insper-riscv/RV32I/docs/img/multi-stage-rv32m_pipeline-Pipeline.jpg.jpeg

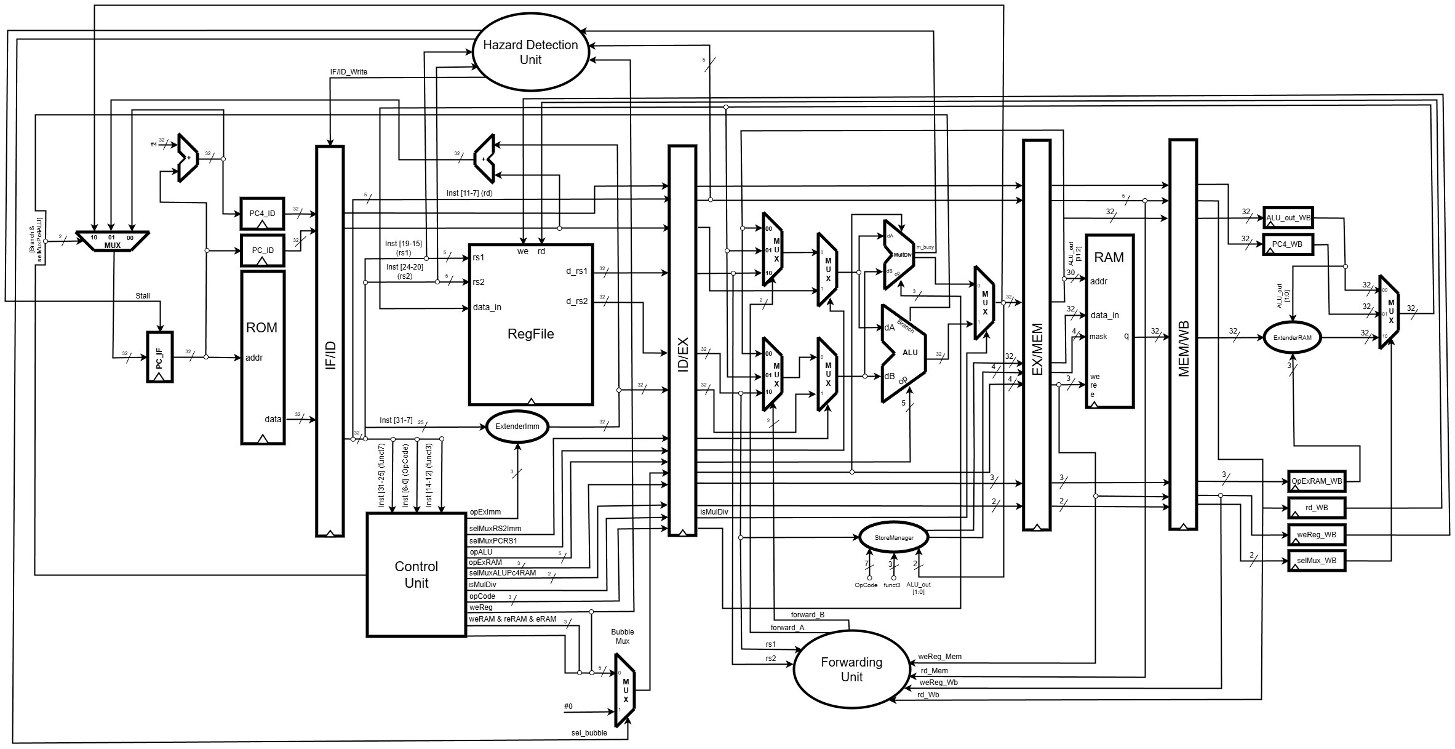
docs/img/multi-stage-rv32m_pipeline-Pipeline.jpg.jpeg
