insper-riscv/RV32I/docs/instructions/greencardRISCV.pdf

Change Level Env. Call Environment Breakpoint Environment Return | ECALL EBREAK ERET
Trap Redirect to SupervisorMRTS Redirect Trap to Hypervisor Hypervisor Trap to Supervisor | MRTH HRTS

Interrupt Wait for InterruptWFI
MMU Supervisor FENCE | SFENCE.VM rs1
Arithmetic | ADD | R | ADD | rd,rs1,rs2
ADD Immediate | I | ADDI | rd,rs1,imm
SUBtract | R | SUB | rd,rs1,rs2
Load Upper Imm | U | LUI | rd,imm
Add Upper Imm to PC | U | AUIPC rd,imm | Category Name | Fmt | RVC | RVI equivalent
Logical XOR XOR Immediate OR OR Immediate AND AND Immediate | R I R I R I | XOR rd,rs1,rs2 XORI rd,rs1,imm OR rd,rs1,rs2 ORI rd,rs1,imm AND rd,rs1,rs2 ANDI rd,rs1,imm | Loads Load Word Load Word SP Load Double Load Double SP Load Quad Load Quad SP | CL CI CL CI CL CI | C.LW rd′,rs1′,imm C.LWSP rd,imm C.LD rd′,rs1′,imm C.LDSP rd,imm C.LQ rd′,rs1′,imm C.LQSP rd,imm | LW rd′,rs1′,imm*4 LW rd,sp,imm*4 LD rd′,rs1′,imm*8 LD rd,sp,imm*8 LQ rd′,rs1′,imm*16 LQ rd,sp,imm*16
Compare Set < Set < Immediate Set < Unsigned Set < Imm Unsigned | R I R I | SLT rd,rs1,rs2 SLTI rd,rs1,imm SLTU rd,rs1,rs2 SLTIU rd,rs1,imm | Stores Store Word Store Word SP Store Double Store Double SP Store Quad Store Quad SP | CS CSS CS CSS CS CSS | C.SW rs1′,rs2′,imm C.SWSP rs2,imm C.SD rs1′,rs2′,imm C.SDSP rs2,imm C.SQ rs1′,rs2′,imm C.SQSP rs2,imm | SW rs1′,rs2′,imm*4 SW rs2,sp,imm*4 SD rs1′,rs2′,imm*8 SD rs2,sp,imm*8 SQ rs1′,rs2′,imm*16 SQ rs2,sp,imm*16
Branches Branch = Branch ≠ Branch < Branch ≥ Branch < Unsigned Branch ≥ Unsigned | SB SB SB SB SB SB | BEQ rs1,rs2,imm BNE rs1,rs2,imm BLT rs1,rs2,imm BGE rs1,rs2,imm BLTU rs1,rs2,imm BGEU rs1,rs2,imm
Jump & Link J&L Jump & Link Register | UJ UJ | JAL rd,imm JALR rd,rs1,imm
Synch Synch thread Synch Instr & Data | I I | FENCE FENCE.I
System System CALL System BREAK | I I | SCALL SBREAK
Counters ReaD CYCLE ReaD CYCLE upper Half ReaD TIME ReaD TIME upper Half ReaD INSTR RETired ReaD INSTR upper Half | I I I I I I | RDCYCLE rd RDCYCLEH rd RDTIME rd RDTIMEH rd RDINSTRET rd RDINSTRETH rd | Shifts Shift Left Imm | CI | C.SLLI rd,imm | SLLI rd,rd,imm
| | | Branches Branch=0 Branch≠0 | CB CB | C.BEQZ rs1′,imm C.BNEZ rs1′,imm | BEQ rs1',x0,imm BNE rs1',x0,imm
| | | Jump Jump Jump Register | CJ CR | C.J imm C.JR rd,rs1 | JAL x0,imm JALR x0,rs1,0

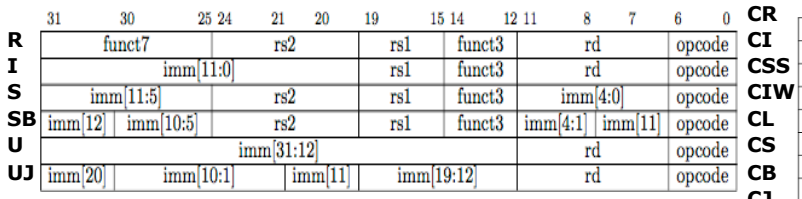
[picture p11: figure]
R CI I CSS S CIW
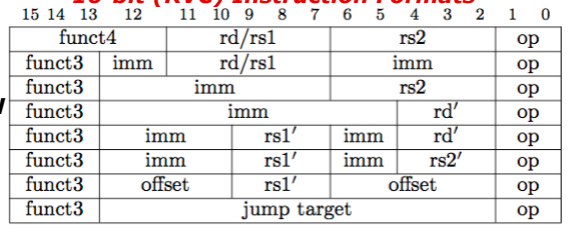
[picture p12: figure]

| | | Jump & Link J&L Jump & Link Register | CJ CR | C.JAL imm C.JALR rs1 | JAL ra,imm JALR ra,rs1,0
| | | System Env. BREAK | CI | C.EBREAK | EBREAK
Arithmetic ADD ADD Word ADD Immediate ADD Word Imm ADD SP Imm * 16 ADD SP Imm * 4 Load Immediate Load Upper Imm MoVe SUB | CR CR CI CI CI CIW CI CI CR CR | C.ADD rd,rs1 C.ADDW rd,rs1 C.ADDI rd,imm C.ADDIW rd,imm C.ADDI16SP x0,imm C.ADDI4SPN rd',imm C.LI rd,imm C.LUI rd,imm C.MV rd,rs1 C.SUB rd,rs1 | ADD rd,rd,rs1 ADDW rd,rd,imm ADDI rd,rd,imm ADDIW rd,rd,imm ADDI sp,sp,imm*16 ADDI rd',sp,imm*4 ADDI rd,x0,imm LUI rd,imm ADD rd,rs1,x0 SUB rd,rd,rs1

CR

CJ
RISC-V Integer Base (RV32I/64I/128I), privileged, and optional compressed extension (RVC). Registers x1-x31 and the pc are 32 bits wide in RV32I, 64 in RV64I, and 128 in RV128I (x0=0). RV64I/128I add 10 instructions for the wider formats. The RVI base of <50 classic integer RISC instructions is required. Every 16-bit RVC instruction matches an existing 32-bit RVI instruction. See risc.org.
32-bit Instruction Formats | 16-bit (RVC) Instruction Formats

ADD{W|D} rd,rs1,rs2 ADDI{W|D} rd,rs1,imm SUB{W|D} rd,rs1,rs2

## Optional Compressed (16-bit) Instruction Extension: RVC

Free & Open | Reference Card | ①
Base Integer Instructions: RV32I, RV64I, and RV128I | RV Privileged Instructions
Category Name | Fmt | RV32I Base | +RV{64,128} | Category Name | RV mnemonic
Loads Load Byte Load Halfword Load Word Load Byte Unsigned Load Half Unsigned | I I I I I | LB rd,rs1,imm LH rd,rs1,imm LW rd,rs1,imm LBU rd,rs1,imm LHU rd,rs1,imm | L{D|Q} rd,rs1,imm L{W|D}U rd,rs1,imm | CSR Access Atomic R/W Atomic Read & Set Bit Atomic Read & Clear Bit Atomic R/W Imm Atomic Read & Set Bit Imm Atomic Read & Clear Bit Imm | CSRRW rd,csr,rs1 CSRRS rd,csr,rs1 CSRRC rd,csr,rs1 CSRRWI rd,csr,imm CSRRSI rd,csr,imm CSRRCI rd,csr,imm
Stores Store Byte Store Halfword Store Word | S S S | SB rs1,rs2,imm SH rs1,rs2,imm SW rs1,rs2,imm | S{D|Q} rs1,rs2,imm
Shifts Shift Left Shift Left Immediate Shift Right Shift Right Immediate Shift Right Arithmetic Shift Right Arith Imm | R I R I R I | SLL rd,rs1,rs2 SLLI rd,rs1,shamt SRL rd,rs1,rs2 SRLI rd,rs1,shamt SRA rd,rs1,rs2 SRAI rd,rs1,shamt | SLL{W|D} rd,rs1,rs2 SLLI{W|D} rd,rs1,shamt SRL{W|D} rd,rs1,rs2 SRLI{W|D} rd,rs1,shamt SRA{W|D} rd,rs1,rs2 SRAI{W|D} rd,rs1,shamt

Category Name | Fmt | RV32M (Multiply-Divide) | +RV{64,128}
Multiply MULtiply MULtiply upper Half MULtiply Half Sign/Uns MULtiply upper Half Uns Divide DIVide DIVide Unsigned Remainder REMainder REMainder Unsigned | R R R R R R R R | MUL rd,rs1,rs2 MULH rd,rs1,rs2 MULHSU rd,rs1,rs2 MULHU rd,rs1,rs2 DIV rd,rs1,rs2 DIVU rd,rs1,rs2 REM rd,rs1,rs2 REMU rd,rs1,rs2 | MUL{W|D} rd,rs1,rs2 DIV{W|D} rd,rs1,rs2 REM{W|D} rd,rs1,rs2 REMU{W|D} rd,rs1,rs2
Category Name | Fmt | RV32A (Atomic) | +RV{64,128}
Load Load Reserved | R | LR.W rd,rs1 | LR.{D|Q} rd,rs1
Store Store Conditional | R | SC.W rd,rs1,rs2 | SC.{D|Q} rd,rs1,rs2
Swap SWAP | R | AMOSWAP.W rd,rs1,rs2 | AMOSWAP.{D|Q} rd,rs1,rs2
Add ADD | R | AMOADD.W rd,rs1,rs2 | AMOADD.{D|Q} rd,rs1,rs2
Logical XOR AND OR | R R R | AMOXOR.W rd,rs1,rs2 AMOAND.W rd,rs1,rs2 AMOOR.W rd,rs1,rs2 | AMOXOR.{D|Q} rd,rs1,rs2 AMOAND.{D|Q} rd,rs1,rs2 AMOOR.{D|Q} rd,rs1,rs2
Min/Max MINimum MAXimum MINimum Unsigned MAXimum Unsigned | R R R R | AMOMIN.W rd,rs1,rs2 AMOMAX.W rd,rs1,rs2 AMOMINU.W rd,rs1,rs2 AMOMAXU.W rd,rs1,rs2 | AMOMIN.{D|Q} rd,rs1,rs2 AMOMAX.{D|Q} rd,rs1,rs2 AMOMINU.{D|Q} rd,rs1,rs2 AMOMAXU.{D|Q} rd,rs1,rs2
Category Name | Fmt | RV32{F|D|Q} (HP/SP,DP,QP Fl Pt) | +RV{64,128}
Move Move from Integer Move to Integer | R R | FMV.{H|S}.X rd,rs1 FMV.X.{H|S} rd,rs1 | FMV.{D|Q}.X rd,rs1 FMV.X.{D|Q} rd,rs1
Convert Convert from Int Convert from Int Unsigned Convert to Int Convert to Int Unsigned | R R R R | FCVT.{H|S|D|Q}.W rd,rs1 FCVT.{H|S|D|Q}.WU rd,rs1 FCVT.W.{H|S|D|Q} rd,rs1 FCVT.WU.{H|S|D|Q} rd,rs1 | FCVT.{H|S|D|Q}.{L|T} rd,rs1 FCVT.{H|S|D|Q}.{L|T}U rd,rs1 FCVT.{L|T}.{H|S|D|Q} rd,rs1 FCVT.{L|T}U.{H|S|D|Q} rd,rs1
Load Load | I | FL{W,D,Q} rd,rs1,imm | RISC-V Calling Convention
Store Store | S | FS{W,D,Q} rs1,rs2,imm | Register | ABI Name | Saver | Description
Arithmetic ADD SUBtract MULtiply DIVide SQuare RooT | R R R R R | FADD.{S|D|Q} rd,rs1,rs2 FSUB.{S|D|Q} rd,rs1,rs2 FMUL.{S|D|Q} rd,rs1,rs2 FDIV.{S|D|Q} rd,rs1,rs2 FSQRT.{S|D|Q} rd,rs1 | x0 x1 x2 x3 x4 x5-7 x8 x9 x10-11 x12-17 x18-27 x28-31 | zero ra sp gp tp t0-2 s0/fp s1 a0-1 a2-7 s2-11 t3-t6 | ---Caller Callee ------Caller Callee Callee Caller Caller Callee Caller | Hard-wired zero Return address Stack pointer Global pointer Thread pointer Temporaries Saved register/frame pointer Saved register Function arguments/return values Function arguments Saved registers Temporaries
Mul-Add Multiply-ADD Multiply-SUBtract Negative Multiply-SUBtract Negative Multiply-ADD | R R R R | FMADD.{S|D|Q} rd,rs1,rs2,rs3 FMSUB.{S|D|Q} rd,rs1,rs2,rs3 FNMSUB.{S|D|Q} rd,rs1,rs2,rs3 FNMADD.{S|D|Q} rd,rs1,rs2,rs3
Sign Inject SiGN source Negative SiGN source Xor SiGN source | R R R | FSGNJ.{S|D|Q} rd,rs1,rs2 FSGNJN.{S|D|Q} rd,rs1,rs2 FSGNJX.{S|D|Q} rd,rs1,rs2
Min/Max MINimum MAXimum | R R | FMIN.{S|D|Q} rd,rs1,rs2 FMAX.{S|D|Q} rd,rs1,rs2 | f0-7 f8-9 f10-11 f12-17 f18-27 f28-31 | ft0-7 fs0-1 fa0-1 fa2-7 fs2-11 ft8-11 | Caller Callee Caller Caller Callee Caller | FP temporaries FP saved registers FP arguments/return values FP arguments FP saved registers FP temporaries
Compare Compare Float = Compare Float < Compare Float ≤ Categorization Classify Type | R R R R | FEQ.{S|D|Q} rd,rs1,rs2 FLT.{S|D|Q} rd,rs1,rs2 FLE.{S|D|Q} rd,rs1,rs2 FCLASS.{S|D|Q} rd,rs1
Configuration Read Status Read Rounding Mode Read Flags Swap Status Reg Swap Rounding Mode Swap Flags Swap Rounding Mode Imm Swap Flags Imm | R R R R R R I I | FRCSR rd FRRM rd FRFLAGS rd FSCSR rd,rs1 FSRM rd,rs1 FSFLAGS rd,rs1 FSRMI rd,imm FSFLAGSI rd,imm

RISC-V calling convention and five optional extensions: 10 multiply-divide instructions (RV32M); 11 optional atomic instructions (RV32A); and 25 floating-point instructions each for single-, double-, and quadruple-precision (RV32F, RV32D, RV32Q). The latter add registers f0-f31, whose width matches the widest precision, and a floating-point control and status register fcsr. Each larger address adds some instructions: 4 for RVM, 11 for RVA, and 6 each for RVF/D/Q. Using regex notation, {} means set, so L{D|Q} is both LD and LQ. See risc.org. (8/21/15 revision)

## Three Optional Floating-Point Instruction Extensions: RVF, RVD, & RVQ

## Optional Atomic Instruction Extension: RVA

Free & Open | Reference Card (riscv.org) ② Optional Multiply-Divide Instruction Extension: RVM
