insper-riscv/RV32I/tests/python/unittests/entities/data/riscv_opcodes.csv

INST | IMPL | OpCode[6:0] | funct3[2:0] | funct7[6:0] | SelMuxPc4ALU | opExImm[2:0] | selMuxALUPc4RAM[1:0] | weReg | opExRAM[2:0] | selMuxRS2Imm | selMUXPcRS1 | opALU[4:0] | reRAM | eRAM | weRAM
LUI | x[rd] = sext(imm << 12) | 0110111 | - | - | 0 | U | 00 | 1 | XXX | 1 | X | PASS_B | 0 | 0 | 0
AUIPC | x[rd] = pc + sext(imm << 12) | 0010111 | - | - | 0 | U | 00 | 1 | XXX | 1 | 0 | ADD | 0 | 0 | 0
ADDI | x[rd] = x[rs1] + sext(imm) | 0010011 | 000 | - | 0 | I | 00 | 1 | XXX | 1 | 1 | ADD | 0 | 0 | 0
XORI | x[rd] = x[rs1] ^ sext(imm) | 0010011 | 100 | - | 0 | I | 00 | 1 | XXX | 1 | 1 | XOR | 0 | 0 | 0
ORI | x[rd] = x[rs1] | sext(imm) | 0010011 | 110 | - | 0 | I | 00 | 1 | XXX | 1 | 1 | OR | 0 | 0 | 0
ANDI | x[rd] = x[rs1] & sext(imm) | 0010011 | 111 | - | 0 | I | 00 | 1 | XXX | 1 | 1 | AND | 0 | 0 | 0
SLLI | x[rd] = x[rs1] << shamt | 0010011 | 001 | 0000000 | 0 | I_shamt | 00 | 1 | XXX | 1 | 1 | SLL | 0 | 0 | 0
SRLI | x[rd] = x[rs1] >>u shamt | 0010011 | 101 | 0000000 | 0 | I_shamt | 00 | 1 | XXX | 1 | 1 | SRL | 0 | 0 | 0
SRAI | x[rd] = x[rs1] >>s shamt | 0010011 | 101 | 0100000 | 0 | I_shamt | 00 | 1 | XXX | 1 | 1 | SRA | 0 | 0 | 0
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
