insper-riscv/RV32I/L2IP/hw/RTL View Completo 11 03 2026.pdf

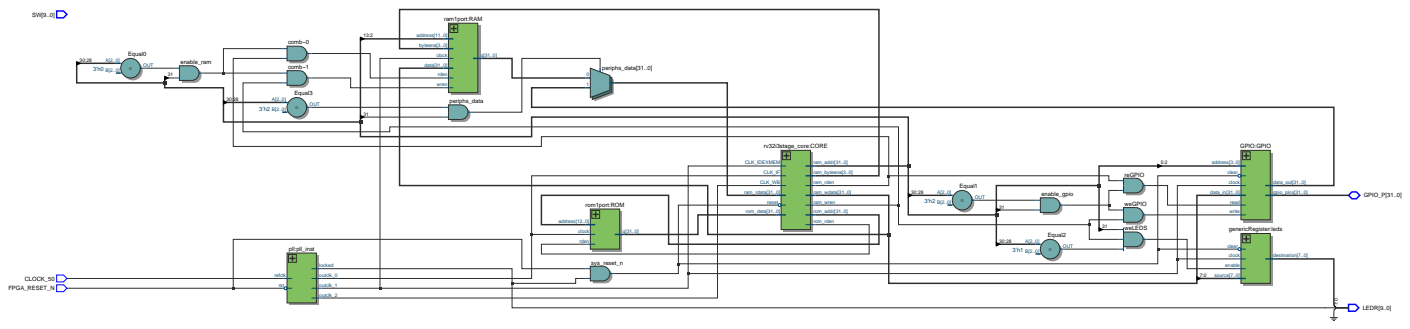
[picture p15: page 1]
CLOCK_50 FPGA_RESET_N; Equal0; OUT; enable_ram; comb~0 comb~1 =; Equal3; pll:pll_inst; refclk; rst; locked; outclk_0; outclk_1; outclk_2; ram1port:RAM; clock; rden wren; address[11..0] byteena[3..0]; data[31..0]; periphs_data; periphs_data[31..0] 01; rom1port:ROM; rden; address[12..0]; sys_reset_n; rv32i3stage_core:CORE; CLK_IDEXMEM; CLK_IF CLK_WB; reset; rom_data[31..0]; ram_rdata[31..0]; ram_rden; ram_wren; rom_rden; rom_addr[31..0]; ram_addr[31..0]; ram_wdata[31..0]; ram_byteena[3..0]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
