insper-riscv/RV32I/src/rv32im_pipeline_core.vhd

-- =============================================================================
-- rv32im_pipeline_core.vhd
-- Top-level do pipeline RV32IM 5 estagios -- PIPELINE COMPLETO
-- M1: IF + ID + Control Unit + Bubble Mux + HDU + reg_IF_ID + reg_ID_EX
-- M2: EX + reg_EX_MEM + Forwarding Unit + muxes de operandos + logica de branch
-- M3: MEM + WB + reg_MEM_WB + ExtenderRAM + mux final de WB
--
-- EVOLUCAO M3 em relacao a M2:
--   1. Estagio MEM: conectado diretamente via sinais exmem_* (ja estava
--      parcialmente feito em M2). A RAM tem leitura sincrona de 1 ciclo.
--   2. Estagio WB completamente instanciado:
--      - reg_MEM_WB captura metadata do MEM (NAO captura ram_rdata, pois
--        a RAM e registrada e o dado chega no ciclo WB naturalmente).
--      - ExtenderRAM posicionado em WB: recebe ram_rdata + opExRAM_WB +
--        alu_out_WB[1:0] (EA = byte offset) e produz o dado de load extendido.
--      - Mux final de WB: seleciona entre ALU, PC+4 e saida do ExtenderRAM
--        de acordo com selMuxALUPc4RAM_WB.
--   3. Loop do RegFile fechado:
--      - wb_we   <- memwb_weReg
--      - wb_rd   <- memwb_rd_idx
--      - wb_data <- saida do mux final de WB
--   4. Forwarding Unit atualizado: agora conecta memwb_rd_idx e memwb_weReg
--      diretamente (em M2 eram stubs apontando para wb_we/wb_rd constantes).
--
-- CONVENCAO DE ENCODING DO wbsel_t (usado em selMuxALUPc4RAM):
--   "00" = ALU (R-type, I-type ALU, AUIPC, LUI)
--   "01" = PC+4 (JAL, JALR)
--   "10" = RAM extendida (LW/LH/LB/LHU/LBU)
--
--   ATENCAO: Verificar se a Control Unit usa este mesmo encoding ao atribuir
--   selMuxALUPc4RAM. Se usar outra convencao, basta reordenar os casos no
--   mux final de WB (procurar por "Mux final de WB" abaixo).
-- =============================================================================

library ieee;
use ieee.std_logic_1164.all;
use ieee.numeric_std.all;
use work.rv32i_ctrl_consts.all;
use work.rv32im_pipeline_types.all;

entity rv32im_pipeline_core is
  port (
    clk   : in  std_logic;
    reset : in  std_logic;

    -- Interface de busca de instrucao (estagio IF) -- barramento UNICO
    -- compartilhado por BOOT_ROM e FLASH (ambas sempre respondem ao
    -- mesmo endereco if_pc todo ciclo; is_boot_rom_if/is_boot_rom_d
    -- abaixo decidem qual dado confiar). 3 memorias fisicas agora:
    -- BOOT_ROM (fixa, gravada uma unica vez, nunca reescrita via JTAG
    -- por teste) + FLASH (o "firmware", reescrita por teste) + RAM
    -- (dados de verdade, unico consumidor do estagio MEM). Ver
    -- link.ld/config.yaml memory.boot_rom_words/rom_words/ram_words.
    if_addr       : out std_logic_vector(31 downto 0);
    if_rden       : out std_logic;
    boot_rom_data : in  std_logic_vector(31 downto 0);
    flash_data    : in  std_logic_vector(31 downto 0);

    -- Interface de leitura de dado pelo estagio MEM, so' para FLASH
    -- (BOOT_ROM nunca tem .data proprio -- ver boot_rom.S -- entao
    -- nunca precisa ser lido como dado). Necessaria especificamente
    -- para o copy-loop de _boot_continue (boot_rom.S) conseguir ler
    -- .data da FLASH (a fonte, LMA) e escrever na RAM (o destino,
    -- VMA) -- confirmado em hardware real que sem isso o `lw` do
    -- copy-loop simplesmente nao alcancava FLASH (so' RAM), entao
    -- .data nunca era copiado (bss/computo funcionavam normalmente,
    -- so' .data inicializado ficava zerado). Fiel ao que uma SoC de
    -- verdade faz (a CPU le a Flash como dado pra copiar pra RAM no
    -- boot, via o mesmo controlador memory-mapped que atende busca de
    -- instrucao) -- a segunda instancia fisica do lado de hardware
    -- real (ver core_fpga_test.vhd FLASH_MEM) e' um artefato do
    -- Quartus Lite (DUAL_PORT + ENABLE_RUNTIME_MOD nao compilam
    -- juntos), nao algo que uma SoC real precisaria.
    flash_addr2 : out std_logic_vector(31 downto 0);
    flash_rden2 : out std_logic;
    flash_data2 : in  std_logic_vector(31 downto 0);

    -- Interface com a RAM
    ram_addr    : out std_logic_vector(31 downto 0);
    ram_wdata   : out std_logic_vector(31 downto 0);
    ram_rdata   : in  std_logic_vector(31 downto 0);
    ram_en      : out std_logic;
    ram_wren    : out std_logic;
    ram_rden    : out std_logic;
    ram_byteena : out std_logic_vector(3 downto 0)
  );
end entity rv32im_pipeline_core;

architecture rtl of rv32im_pipeline_core is

  -- =========================================================================
  -- Sinais de controle de hazard (gerados pela HDU)
  -- =========================================================================
  signal if_pc_write_en : std_logic;
  signal ifid_write_en  : std_logic;
  signal id_bubble_sel  : std_logic;

  -- =========================================================================
  -- Sinais de controle de branch (gerados no estagio EX)
  -- =========================================================================
  signal ex_branch_taken  : std_logic;
  signal ex_jalr_taken    : std_logic;
  signal ex_branch_target : word_t;
  signal ex_jalr_target   : word_t;
  signal pc_src           : std_logic_vector(1 downto 0);

  signal flush_if_id : std_logic;
  signal flush_id_ex : std_logic;

  -- =========================================================================
  -- Stall do muldiv (combinacional = sempre '0' nesta implementacao)
  -- =========================================================================
  signal muldiv_busy   : std_logic;
  signal muldiv_done   : std_logic;
  signal muldiv_stall  : std_logic;  -- busy OR done (cobre ciclo em que saida_capt atualiza)
  signal muldiv_stall_n : std_logic;  -- NOT muldiv_stall (para port maps VHDL-93)

  -- Aliases para visibilidade nos testbenches cocotb
  signal alu_out_idexmem  : word_t;
  signal pc_if_out        : word_t;
  signal extenderRAM_out  : word_t;
  signal ram_out          : std_logic_vector(31 downto 0);

  -- =========================================================================
  -- Estagio IF: pc_fetch
  -- =========================================================================
  signal if_pc  : word_t;
  signal if_pc4 : word_t;

  -- BOOT_ROM x FLASH: decodificacao de endereco de busca, puramente
  -- combinacional (ver comentario junto do mux, mais abaixo, para o
  -- porque de NAO ter um registrador aqui -- um registrador extra
  -- causou um bug real de alinhamento de clock, so' visivel em
  -- hardware real, nao no GHDL).
  --
  -- 2K (512 words) -- folga confortavel para o bootloader fixo
  -- (boot_rom.S: trampolim + copy-loop + bss-zero + rv32_wait_restart),
  -- sem TLS/outras miudezas que o crt0.S antigo carregava mas nada
  -- usa. Precisa bater com boot_rom.ld (BOOT_ROM_SIZE) e config.yaml
  -- memory.boot_rom_words (=512).
  constant BOOT_ROM_SIZE_BYTES : unsigned(31 downto 0) := to_unsigned(16#00000800#, 32);
  signal is_boot_rom_if : std_logic;
  signal if_instr_mux   : std_logic_vector(31 downto 0);

  -- FLASH x RAM: decodificacao de endereco de dado (estagio MEM/WB) --
  -- ver comentario junto do mux, na secao do estagio MEM. RAM_BASE_BYTES
  -- precisa bater com config.yaml memory.ram_base.
  constant RAM_BASE_BYTES : unsigned(31 downto 0) := to_unsigned(16#00008000#, 32);
  signal is_flash_data    : std_logic;  -- decodificado no estagio MEM (exmem_alu_out)
  signal is_flash_data_wb : std_logic;  -- mesmo decode, 1 ciclo depois, para o mux de WB
  signal mem_read_data    : std_logic_vector(31 downto 0);  -- FLASH(porta 2) ou RAM, o que o WB consome

  -- =========================================================================
  -- Registrador IF/ID
  -- =========================================================================
  signal ifid_valid : std_logic;
  signal ifid_pc    : word_t;
  signal ifid_pc4   : word_t;
  signal ifid_instr : word_t;

  signal ifid_rs1 : reg_t;
  signal ifid_rs2 : reg_t;

  -- =========================================================================
  -- Estagio ID
  -- =========================================================================
  signal id_rs1_idx : reg_t;
  signal id_rs2_idx : reg_t;
  signal id_rd_idx  : reg_t;
  signal id_rs1_val : word_t;
  signal id_rs2_val : word_t;
  signal id_imm     : word_t;

  -- =========================================================================
  -- Control Unit
  -- =========================================================================
  signal cu_selMuxPc4ALU    : std_logic;
  signal cu_opExImm         : opeximm_t;
  signal cu_selMuxALUPc4RAM : wbsel_t;
  signal cu_weReg           : std_logic;
  signal cu_opExRAM         : opexram_t;
  signal cu_selMuxRS2Imm    : std_logic;
  signal cu_selPCRS1        : std_logic;
  signal cu_opALU           : opalu_t;
  signal cu_isMulDiv        : std_logic;
  signal cu_weRAM           : std_logic;
  signal cu_reRAM           : std_logic;
  signal cu_eRAM            : std_logic;
  signal cu_opCode          : std_logic_vector(6 downto 0);
  signal cu_funct3          : std_logic_vector(2 downto 0);

  signal isMulDiv_d   : std_logic := '0';
  signal startMul_raw : std_logic;

  -- =========================================================================
  -- Bubble Mux
  -- =========================================================================
  signal bm_weReg           : std_logic;
  signal bm_startMul        : std_logic;
  signal bm_weRAM           : std_logic;
  signal bm_reRAM           : std_logic;
  signal bm_eRAM            : std_logic;
  signal idex_in_valid      : std_logic;

  -- =========================================================================
  -- Saidas do reg_ID_EX (entradas do estagio EX)
  -- =========================================================================
  signal ex_valid           : std_logic;
  signal ex_pc              : word_t;
  signal ex_pc4             : word_t;
  signal ex_rs1_idx         : reg_t;
  signal ex_rs2_idx         : reg_t;
  signal ex_rd_idx          : reg_t;
  signal ex_rs1_val         : word_t;
  signal ex_rs2_val         : word_t;
  signal ex_imm             : word_t;
  signal ex_selMuxPc4ALU    : std_logic;
  signal ex_selMuxALUPc4RAM : wbsel_t;
  signal ex_weReg           : std_logic;
  signal ex_opExRAM         : opexram_t;
  signal ex_selMuxRS2Imm    : std_logic;
  signal ex_selPCRS1        : std_logic;
  signal ex_opALU           : opalu_t;
  signal ex_isMulDiv        : std_logic;
  signal ex_startMul        : std_logic;
  signal ex_weRAM           : std_logic;
  signal ex_reRAM           : std_logic;
  signal ex_eRAM            : std_logic;
  signal ex_opCode          : std_logic_vector(6 downto 0);
  signal ex_funct3          : std_logic_vector(2 downto 0);

  -- =========================================================================
  -- Estagio EX: forwarding e operandos
  -- =========================================================================
  signal ex_forward_a   : std_logic_vector(1 downto 0);
  signal ex_forward_b   : std_logic_vector(1 downto 0);
  signal ex_fwd_rs1_val : word_t;
  signal ex_fwd_rs2_val : word_t;
  signal ex_alu_op_a    : word_t;
  signal ex_alu_op_b    : word_t;
  signal exmem_weReg_fwd : std_logic;
  signal memwb_weReg_fwd : std_logic;

  -- =========================================================================
  -- Estagio EX: resultados
  -- =========================================================================
  signal ex_alu_result      : word_t;
  signal ex_alu_branch_flag : std_logic;
  signal ex_muldiv_result   : word_t;
  signal ex_alu_mux_result  : word_t;
  signal ex_final_result    : word_t;

  -- =========================================================================
  -- Estagio EX: StoreManager
  -- =========================================================================
  signal ex_store_data    : word_t;
  signal ex_store_byteena : std_logic_vector(3 downto 0);

  -- =========================================================================
  -- Saidas do reg_EX_MEM (entradas do estagio MEM)
  -- =========================================================================
  signal exmem_valid           : std_logic;
  signal exmem_pc4             : word_t;
  signal exmem_alu_out         : word_t;
  signal exmem_store_data      : word_t;
  signal exmem_byteena         : std_logic_vector(3 downto 0);
  signal exmem_rd_idx          : reg_t;
  signal exmem_weReg           : std_logic;
  signal exmem_weRAM           : std_logic;
  signal exmem_reRAM           : std_logic;
  signal exmem_eRAM            : std_logic;
  signal exmem_opExRAM         : opexram_t;
  signal exmem_selMuxALUPc4RAM : wbsel_t;

  -- =========================================================================
  -- Saidas do reg_MEM_WB (entradas do estagio WB)
  -- =========================================================================
  signal memwb_valid           : std_logic;
  signal memwb_pc4             : word_t;
  signal memwb_alu_out         : word_t;
  signal memwb_rd_idx          : reg_t;
  signal memwb_weReg           : std_logic;
  signal memwb_opExRAM         : opexram_t;
  signal memwb_selMuxALUPc4RAM : wbsel_t;

  -- =========================================================================
  -- Estagio WB: saida do ExtenderRAM (dado de load extendido)
  -- =========================================================================
  signal wb_ram_extended : word_t;

  -- =========================================================================
  -- Write-back: sinais que fecham o loop no RegFile
  -- =========================================================================
  signal wb_we   : std_logic;
  signal wb_rd   : reg_t;
  signal wb_data : word_t;

begin

  -- Aliases de observabilidade para testbenches cocotb
  alu_out_idexmem <= exmem_alu_out;
  pc_if_out       <= if_pc;
  extenderRAM_out <= wb_ram_extended;
  ram_out         <= ram_rdata;

  -- =========================================================================
  -- Logica combinacional de controle de PC e flush
  -- =========================================================================
  pc_src <= "10" when ex_jalr_taken   = '1' else
            "01" when ex_branch_taken = '1' else
            "00";

  flush_if_id <= ex_branch_taken or ex_jalr_taken;
  flush_id_ex <= ex_branch_taken or ex_jalr_taken;

  -- =========================================================================
  -- Edge detect de isMulDiv para gerar startMul (pulso de 1 ciclo)
  -- =========================================================================
  process(clk)
  begin
    if rising_edge(clk) then
      if reset = '1' then
        isMulDiv_d <= '0';
      elsif ifid_write_en = '1' then
        isMulDiv_d <= cu_isMulDiv;
      end if;
    end if;
  end process;

  startMul_raw <= cu_isMulDiv and (not isMulDiv_d);

  -- BUG TIMING (resolvido): saida_capt no multdiv eh atualizado na borda quando done_int=1.
  -- No ciclo em que done_int=1, busy ja caiu para 0 (Booth foi para S_DONE no ciclo anterior).
  -- Sem este OR done, reg_EX_MEM capturaria saida_capt VELHO nesse ciclo.
  -- Com "OR done", o stall continua por 1 ciclo extra ate saida_capt propagar.
  muldiv_stall   <= muldiv_busy or muldiv_done;
  muldiv_stall_n <= not (muldiv_busy or muldiv_done);

  idex_in_valid <= ifid_valid and (not id_bubble_sel);

  -- =========================================================================
  -- Campos extraidos da instrucao em IF/ID
  -- =========================================================================
  ifid_rs1   <= ifid_instr(19 downto 15);
  ifid_rs2   <= ifid_instr(24 downto 20);
  id_rs1_idx <= ifid_instr(19 downto 15);
  id_rs2_idx <= ifid_instr(24 downto 20);
  id_rd_idx  <= ifid_instr(11 downto 7);

  -- =========================================================================
  -- IF stage: pc_fetch
  -- =========================================================================
  u_pc_fetch : entity work.pc_fetch
    port map (
      clk            => clk,
      reset          => reset,
      if_pc_write_en => if_pc_write_en,
      pc_src         => pc_src,
      branch_target  => ex_branch_target,
      jalr_target    => ex_jalr_target,
      pc_out         => if_pc,
      pc4_out        => if_pc4,
      rom_addr       => if_addr,
      rom_rden       => if_rden
    );

  -- BOOT_ROM x FLASH: decode + mux (ver comentario junto do sinal, acima).
  --
  -- BUG REAL, CONFIRMADO EM HARDWARE (nao aparecia no GHDL): a versao
  -- anterior deste trecho REGISTRAVA is_boot_rom_if (is_boot_rom_d,
  -- amostrado em `clk` = pll_clk_idexmem) antes de usar no mux. Isso
  -- introduz UM CICLO A MAIS de atraso do que o necessario, porque
  -- reg_IF_ID tambem captura in_pc <= if_pc DIRETO (sem registrador
  -- extra) -- para o endereco (in_pc) e a instrucao (in_instr) ficarem
  -- alinhados no MESMO ciclo de captura, o select do mux tem que usar
  -- o MESMO if_pc "atual" (pre-borda), nao uma copia atrasada.
  --
  -- No hardware real, pll_clk_if e pll_clk_idexmem sao saidas
  -- ESTAGADAS da MESMA PLL (ver src/PLL/pll_0002.v: outclk_0 fase 0,
  -- outclk_1 fase 6667ps -- 1/3 de um periodo de 20ns), nao um clock
  -- unico como o clk_gen_3way do GHDL modelava (sem essa defasagem
  -- real) -- e' exatamente essa defasagem real que expos o
  -- off-by-one: com o registrador extra, o mux acabava selecionando
  -- com o endereco de DOIS ciclos atras em vez de um, entao a
  -- instrucao que reg_IF_ID capturava nunca correspondia ao PC real
  -- (o core nunca saia do boot corretamente -- mailbox nunca era
  -- escrita, confirmado via `riscv-tools run` na placa).
  --
  -- Combinacional resolve: is_boot_rom_if (decodificado do if_pc
  -- "atual", pre-borda) e' exatamente o mesmo sinal que reg_IF_ID usa
  -- para in_pc nesse mesmo instante -- sem registrador extra, sem
  -- reset explicito precisando tratar o vetor de reset (if_pc=0 no
  -- reset ja decodifica '1' sozinho, ja que 0 < BOOT_ROM_SIZE_BYTES).
  is_boot_rom_if <= '1' when unsigned(if_pc) < BOOT_ROM_SIZE_BYTES else '0';

  if_instr_mux <= boot_rom_data when is_boot_rom_if = '1' else flash_data;

  -- =========================================================================
  -- Registrador IF/ID
  -- =========================================================================
  u_reg_if_id : entity work.reg_IF_ID
    port map (
      clk           => clk,
      reset         => reset,
      ifid_write_en => ifid_write_en,
      flush         => flush_if_id,
      in_pc         => if_pc,
      in_pc4        => if_pc4,
      in_instr      => if_instr_mux,
      ifid_valid    => ifid_valid,
      ifid_pc       => ifid_pc,
      ifid_pc4      => ifid_pc4,
      ifid_instr    => ifid_instr
    );

  -- =========================================================================
  -- ID stage: Control Unit
  -- =========================================================================
  u_control_unit : entity work.control_unit
    port map (
      instruction     => ifid_instr,
      selMuxPc4ALU    => cu_selMuxPc4ALU,
      opExImm         => cu_opExImm,
      selMuxALUPc4RAM => cu_selMuxALUPc4RAM,
      weReg           => cu_weReg,
      opExRAM         => cu_opExRAM,
      selMuxRS2Imm    => cu_selMuxRS2Imm,
      selPCRS1        => cu_selPCRS1,
      opALU           => cu_opALU,
      isMulDiv        => cu_isMulDiv,
      weRAM           => cu_weRAM,
      reRAM           => cu_reRAM,
      eRAM            => cu_eRAM,
      opCode          => cu_opCode,
      funct3_out      => cu_funct3
    );

  -- =========================================================================
  -- ID stage: ExtenderImm
  -- =========================================================================
  u_extender_imm : entity work.ExtenderImm
    port map (
      Inst31downto7 => ifid_instr(31 downto 7),
      opExImm       => std_logic_vector(cu_opExImm),
      signalOut     => id_imm
    );

  -- =========================================================================
  -- ID stage: RegFile
  -- Agora com loop fechado: wb_we/wb_rd/wb_data vem do estagio WB.
  -- =========================================================================
  u_regfile : entity work.RegFile
    port map (
      clk     => clk,
      clear   => reset,
      we      => wb_we,
      rs1     => id_rs1_idx,
      rs2     => id_rs2_idx,
      rd      => wb_rd,
      data_in => wb_data,
      d_rs1   => id_rs1_val,
      d_rs2   => id_rs2_val
    );

  -- =========================================================================
  -- Hazard Detection Unit
  -- =========================================================================
  u_hdu : entity work.hazard_detection_unit
    port map (
      ifid_valid     => ifid_valid,
      ifid_rs1       => ifid_rs1,
      ifid_rs2       => ifid_rs2,
      ifid_opcode    => ifid_instr(6 downto 0),
      idex_rd        => ex_rd_idx,
      idex_reRAM     => ex_reRAM,
      muldiv_busy    => muldiv_stall,
      if_pc_write_en => if_pc_write_en,
      ifid_write_en  => ifid_write_en,
      id_bubble_sel  => id_bubble_sel
    );

  -- =========================================================================
  -- Bubble Mux
  -- =========================================================================
  u_bubble_mux : entity work.bubble_mux
    port map (
      sel_bubble        => id_bubble_sel,
      weReg_i           => cu_weReg,
      weRAM_i           => cu_weRAM,
      reRAM_i           => cu_reRAM,
      eRAM_i            => cu_eRAM,
      startMul_i        => startMul_raw,
      weReg_o           => bm_weReg,
      weRAM_o           => bm_weRAM,
      reRAM_o           => bm_reRAM,
      eRAM_o            => bm_eRAM,
      startMul_o        => bm_startMul
    );

  -- =========================================================================
  -- Registrador ID/EX
  -- =========================================================================
  u_reg_id_ex : entity work.reg_ID_EX
    port map (
      clk    => clk,
      reset  => reset,
      en     => muldiv_stall_n,
      flush  => flush_id_ex,

      in_valid   => idex_in_valid,
      in_pc      => ifid_pc,
      in_pc4     => ifid_pc4,
      in_rs1_idx => id_rs1_idx,
      in_rs2_idx => id_rs2_idx,
      in_rd_idx  => id_rd_idx,
      in_rs1_val => id_rs1_val,
      in_rs2_val => id_rs2_val,
      in_imm     => id_imm,

      in_selMuxPc4ALU    => cu_selMuxPc4ALU,
      in_selMuxALUPc4RAM => cu_selMuxALUPc4RAM,
      in_weReg           => bm_weReg,
      in_opExRAM         => cu_opExRAM,
      in_selMuxRS2Imm    => cu_selMuxRS2Imm,
      in_selPCRS1        => cu_selPCRS1,
      in_opALU           => cu_opALU,
      in_isMulDiv        => cu_isMulDiv,
      in_startMul        => bm_startMul,
      in_weRAM           => bm_weRAM,
      in_reRAM           => bm_reRAM,
      in_eRAM            => bm_eRAM,
      in_opCode          => cu_opCode,
      in_funct3          => cu_funct3,

      idex_valid           => ex_valid,
      idex_pc              => ex_pc,
      idex_pc4             => ex_pc4,
      idex_rs1_idx         => ex_rs1_idx,
      idex_rs2_idx         => ex_rs2_idx,
      idex_rd_idx          => ex_rd_idx,
      idex_rs1_val         => ex_rs1_val,
      idex_rs2_val         => ex_rs2_val,
      idex_imm             => ex_imm,
      idex_selMuxPc4ALU    => ex_selMuxPc4ALU,
      idex_selMuxALUPc4RAM => ex_selMuxALUPc4RAM,
      idex_weReg           => ex_weReg,
      idex_opExRAM         => ex_opExRAM,
      idex_selMuxRS2Imm    => ex_selMuxRS2Imm,
      idex_selPCRS1        => ex_selPCRS1,
      idex_opALU           => ex_opALU,
      idex_isMulDiv        => ex_isMulDiv,
      idex_startMul        => ex_startMul,
      idex_weRAM           => ex_weRAM,
      idex_reRAM           => ex_reRAM,
      idex_eRAM            => ex_eRAM,
      idex_opCode          => ex_opCode,
      idex_funct3          => ex_funct3
    );

  -- =========================================================================
  -- EX stage: Forwarding Unit
  -- Agora conectado aos sinais reais memwb_* (em M2 eram stubs constantes).
  -- =========================================================================
  exmem_weReg_fwd <= exmem_weReg and exmem_valid;
  memwb_weReg_fwd <= memwb_weReg and memwb_valid;

  u_forwarding_unit : entity work.forwarding_unit
    port map (
      ex_rs1_idx   => ex_rs1_idx,
      ex_rs2_idx   => ex_rs2_idx,
      exmem_rd_idx => exmem_rd_idx,
      exmem_weReg  => exmem_weReg_fwd,
      memwb_rd_idx => memwb_rd_idx,
      memwb_weReg  => memwb_weReg_fwd,
      forward_A    => ex_forward_a,
      forward_B    => ex_forward_b
    );

  -- =========================================================================
  -- EX stage: Muxes de forwarding 3:1
  -- "10" = EX/MEM, "01" = MEM/WB, "00" = ID/EX (RegFile)
  -- =========================================================================
  ex_fwd_rs1_val <= exmem_alu_out when ex_forward_a = "10" else
                    wb_data       when ex_forward_a = "01" else
                    ex_rs1_val;

  ex_fwd_rs2_val <= exmem_alu_out when ex_forward_b = "10" else
                    wb_data       when ex_forward_b = "01" else
                    ex_rs2_val;

  -- =========================================================================
  -- EX stage: Muxes de operandos da ALU
  -- =========================================================================
  ex_alu_op_a <= ex_fwd_rs1_val when ex_selPCRS1 = '1' else ex_pc;
  ex_alu_op_b <= ex_imm when ex_selMuxRS2Imm = '1' else ex_fwd_rs2_val;

  -- =========================================================================
  -- EX stage: ALU
  -- =========================================================================
  u_alu : entity work.ALU
    port map (
      op      => ex_opALU,
      dA      => ex_alu_op_a,
      dB      => ex_alu_op_b,
      dataOut => ex_alu_result,
      branch  => ex_alu_branch_flag
    );

  -- =========================================================================
  -- EX stage: MulDiv
  -- =========================================================================
  u_muldiv : entity work.multdiv
    port map (
      SW     => (others => '0'),
      clk    => clk,
      opCode => ex_funct3,
      valorA => ex_fwd_rs1_val,
      valorB => ex_fwd_rs2_val,
      LEDR   => open,
      saida  => ex_muldiv_result,
      rst    => reset,
      start  => ex_startMul,
      busy   => muldiv_busy,
      done   => muldiv_done
    );

  -- =========================================================================
  -- EX stage: Mux isMulDiv e mux selMuxPc4ALU
  -- =========================================================================
  ex_alu_mux_result <= ex_muldiv_result when ex_isMulDiv     = '1' else ex_alu_result;
  ex_final_result   <= ex_pc4           when ex_selMuxPc4ALU = '1' else ex_alu_mux_result;

  -- =========================================================================
  -- EX stage: Alvos de desvio
  -- =========================================================================
  ex_branch_target <= std_logic_vector(unsigned(ex_pc)          + unsigned(ex_imm));
  ex_jalr_target   <= std_logic_vector(unsigned(ex_fwd_rs1_val) + unsigned(ex_imm))
                        and x"FFFFFFFE";

  -- =========================================================================
  -- EX stage: Decisao de branch/jump tomado
  -- =========================================================================
  ex_branch_taken <= (ex_valid and ex_alu_branch_flag) when ex_opCode = "1100011" else
                      ex_valid                          when ex_opCode = "1101111" else
                     '0';

  ex_jalr_taken   <=  ex_valid when ex_opCode = "1100111" else '0';

  -- =========================================================================
  -- EX stage: StoreManager
  -- =========================================================================
  u_store_manager : entity work.StoreManager
    port map (
      opcode   => ex_opCode,
      funct3   => ex_funct3,
      EA       => ex_alu_result(1 downto 0),
      rs2Val   => ex_fwd_rs2_val,
      data_out => ex_store_data,
      mask     => ex_store_byteena
    );

  -- =========================================================================
  -- Registrador EX/MEM
  -- =========================================================================
  u_reg_ex_mem : entity work.reg_EX_MEM
    port map (
      clk   => clk,
      reset => reset,
      en    => muldiv_stall_n,
      flush => '0',

      in_valid           => ex_valid,
      in_pc4             => ex_pc4,
      in_alu_out         => ex_final_result,
      in_store_data      => ex_store_data,
      in_byteena         => ex_store_byteena,
      in_rd_idx          => ex_rd_idx,
      in_weReg           => ex_weReg,
      in_weRAM           => ex_weRAM,
      in_reRAM           => ex_reRAM,
      in_eRAM            => ex_eRAM,
      in_opExRAM         => ex_opExRAM,
      in_selMuxALUPc4RAM => ex_selMuxALUPc4RAM,

      exmem_valid           => exmem_valid,
      exmem_pc4             => exmem_pc4,
      exmem_alu_out         => exmem_alu_out,
      exmem_store_data      => exmem_store_data,
      exmem_byteena         => exmem_byteena,
      exmem_rd_idx          => exmem_rd_idx,
      exmem_weReg           => exmem_weReg,
      exmem_weRAM           => exmem_weRAM,
      exmem_reRAM           => exmem_reRAM,
      exmem_eRAM            => exmem_eRAM,
      exmem_opExRAM         => exmem_opExRAM,
      exmem_selMuxALUPc4RAM => exmem_selMuxALUPc4RAM
    );

  -- =========================================================================
  -- MEM stage: interface com a RAM e com a segunda porta da FLASH
  --
  -- BOOT_ROM continua fetch-only (nunca tem .data proprio). FLASH
  -- agora tem uma segunda porta de leitura so' para o estagio MEM --
  -- necessaria para _boot_continue (boot_rom.S) conseguir copiar
  -- .data de FLASH pra RAM no boot (confirmado em hardware real:
  -- sem isso, o `lw` do copy-loop nao alcancava FLASH, so' RAM, e
  -- .data nunca era copiado -- ver flash_addr2 no topo do arquivo).
  -- Escrita nunca alcanca FLASH -- fisicamente nao existe wren na
  -- porta 2 (ver core_fpga_test.vhd FLASH_MEM) -- entao ram_wren so'
  -- e' relevante quando o endereco e' mesmo de RAM.
  --
  -- Comparacao (nao 1 bit unico, ja que FLASH e RAM tem tamanhos
  -- diferentes): endereco < RAM_BASE_BYTES cai em FLASH, senao RAM.
  -- Ver config.yaml memory.ram_base -- precisa bater.
  --
  -- A RAM_simulation/RAM1PORT/FLASH (ambas as portas) tem leitura
  -- SINCRONA: quando *_rden='1' no ciclo N, o dado aparece na saida
  -- no ciclo N+1. No ciclo N+1 a instrucao ja estara em WB, e o
  -- ExtenderRAM (posicionado em WB) processara mem_read_data.
  --
  -- Endereco e dado de escrita vem diretamente do reg_EX_MEM.
  -- =========================================================================
  is_flash_data <= '1' when unsigned(exmem_alu_out) < RAM_BASE_BYTES else '0';

  flash_addr2 <= exmem_alu_out;
  flash_rden2 <= exmem_reRAM and exmem_valid and is_flash_data;

  ram_addr    <= exmem_alu_out;
  ram_wdata   <= exmem_store_data;
  ram_en      <= exmem_eRAM  and exmem_valid and (not is_flash_data);
  ram_wren    <= exmem_weRAM and exmem_valid and (not is_flash_data);
  ram_rden    <= exmem_reRAM and exmem_valid and (not is_flash_data);
  ram_byteena <= exmem_byteena;

  -- =========================================================================
  -- Registrador MEM/WB
  -- NAO captura ram_rdata: a RAM e registrada e o dado chega naturalmente
  -- no ciclo WB atraves de ram_rdata.
  -- =========================================================================
  u_reg_mem_wb : entity work.reg_MEM_WB
    port map (
      clk   => clk,
      reset => reset,
      en    => muldiv_stall_n,
      flush => '0',

      in_valid           => exmem_valid,
      in_pc4             => exmem_pc4,
      in_alu_out         => exmem_alu_out,
      in_rd_idx          => exmem_rd_idx,
      in_weReg           => exmem_weReg,
      in_opExRAM         => exmem_opExRAM,
      in_selMuxALUPc4RAM => exmem_selMuxALUPc4RAM,

      memwb_valid           => memwb_valid,
      memwb_pc4             => memwb_pc4,
      memwb_alu_out         => memwb_alu_out,
      memwb_rd_idx          => memwb_rd_idx,
      memwb_weReg           => memwb_weReg,
      memwb_opExRAM         => memwb_opExRAM,
      memwb_selMuxALUPc4RAM => memwb_selMuxALUPc4RAM
    );

  -- =========================================================================
  -- WB stage: mux FLASH(porta 2)/RAM + ExtenderRAM
  --
  -- memwb_alu_out e' o mesmo endereco que gerou o acesso em MEM, um
  -- ciclo atras -- reusa-lo aqui poupa registrar is_flash_data a
  -- parte, ja que o proprio reg_MEM_WB ja carrega alu_out adiante.
  --
  -- Extende o dado lido de acordo com o tipo do load (LB/LH/LW/LBU/LHU)
  -- e o byte offset (alu_out[1:0]).
  -- =========================================================================
  is_flash_data_wb <= '1' when unsigned(memwb_alu_out) < RAM_BASE_BYTES else '0';
  mem_read_data    <= flash_data2 when is_flash_data_wb = '1' else ram_rdata;

  u_extender_ram : entity work.ExtenderRAM
    port map (
      signalIn  => mem_read_data,
      opExRAM   => std_logic_vector(memwb_opExRAM),
      EA        => memwb_alu_out(1 downto 0),
      signalOut => wb_ram_extended
    );

  -- =========================================================================
  -- WB stage: Mux final de WB
  --
  -- Encoding assumido (verificar com a Control Unit):
  --   "00" = ALU (R/I/U-type, AUIPC, LUI)
  --   "01" = PC+4 (JAL, JALR)
  --   "10" = RAM extendida (LW/LH/LB/LHU/LBU)
  -- =========================================================================
  wb_data <= memwb_pc4         when memwb_selMuxALUPc4RAM = "01" else
             wb_ram_extended   when memwb_selMuxALUPc4RAM = "10" else
             memwb_alu_out;  -- default "00"

  -- =========================================================================
  -- WB stage: fechamento do loop no RegFile
  -- =========================================================================
  wb_we <= memwb_weReg and memwb_valid;
  wb_rd <= memwb_rd_idx;

end architecture rtl;
