insper-riscv/RV32I/L2IP/hw/greybox_tmp/greybox_tmp/mgkaj.v

//lpm_mult CBX_SINGLE_OUTPUT_FILE="ON" LPM_HINT="MAXIMIZE_SPEED=5" LPM_PIPELINE=0 LPM_REPRESENTATION="UNSIGNED" LPM_TYPE="LPM_MULT" LPM_WIDTHA=8 LPM_WIDTHB=8 LPM_WIDTHP=16 LPM_WIDTHS=1 clock dataa datab result
//VERSION_BEGIN 25.1 cbx_mgl 2025:10:22:10:31:44:SC cbx_stratixii 2025:10:22:10:31:26:SC cbx_util_mgl 2025:10:22:10:31:27:SC  VERSION_END
// synthesis VERILOG_INPUT_VERSION VERILOG_2001
// altera message_off 10463



// Copyright (C) 2025  Altera Corporation. All rights reserved.
//  Your use of Altera Corporation's design tools, logic functions 
//  and other software and tools, and any partner logic 
//  functions, and any output files from any of the foregoing 
//  (including device programming or simulation files), and any 
//  associated documentation or information are expressly subject 
//  to the terms and conditions of the Altera Program License 
//  Subscription Agreement, the Altera Quartus Prime License Agreement,
//  the Altera IP License Agreement, or other applicable license
//  agreement, including, without limitation, that your use is for
//  the sole purpose of programming logic devices manufactured by
//  Altera and sold by Altera or its authorized distributors.  Please
//  refer to the Altera Software License Subscription Agreements 
//  on the Quartus Prime software download page.



//synthesis_resources = lpm_mult 1 
//synopsys translate_off
`timescale 1 ps / 1 ps
//synopsys translate_on
module  mgkaj
	( 
	clock,
	dataa,
	datab,
	result) /* synthesis synthesis_clearbox=1 */;
	input   clock;
	input   [7:0]  dataa;
	input   [7:0]  datab;
	output   [15:0]  result;

	wire  [15:0]   wire_mgl_prim1_result;

	lpm_mult   mgl_prim1
	( 
	.clock(clock),
	.dataa(dataa),
	.datab(datab),
	.result(wire_mgl_prim1_result));
	defparam
		mgl_prim1.lpm_pipeline = 0,
		mgl_prim1.lpm_representation = "UNSIGNED",
		mgl_prim1.lpm_type = "LPM_MULT",
		mgl_prim1.lpm_widtha = 8,
		mgl_prim1.lpm_widthb = 8,
		mgl_prim1.lpm_widthp = 16,
		mgl_prim1.lpm_widths = 1,
		mgl_prim1.lpm_hint = "MAXIMIZE_SPEED=5";
	assign
		result = wire_mgl_prim1_result;
endmodule //mgkaj
//VALID FILE
