insper-riscv/RV32I/src/TIMER/GENERIC_MUX_2X1.vhd

library IEEE;
use IEEE.STD_LOGIC_1164.ALL;

library WORK;

--! Atribui saída conforme entrada selecionada dentre duas
entity GENERIC_MUX_2X1 is

    generic (
        --! Largura dos vetores de dados
        DATA_WIDTH : natural := 8
    );

    port (
        --! Seletor dos vetores de dados
        selector    : in  std_logic                                   := '0';
        --! Vetor de dados 1
        source_1    : in  std_logic_vector((DATA_WIDTH - 1) downto 0) := (others => '0');
        --! Vetor de dados 2
        source_2    : in  std_logic_vector((DATA_WIDTH - 1) downto 0) := (others => '0');
        --! Vetor de dados selecionado
        destination : out std_logic_vector((DATA_WIDTH - 1) downto 0)
    );

end entity;

architecture RTL of GENERIC_MUX_2X1 is

    signal selector_vec : std_logic_vector((DATA_WIDTH - 1) downto 0);

begin

    selector_vec <= (others => selector);

    destination <= (source_1 AND NOT(selector_vec)) OR (source_2 AND selector_vec);

end architecture;
