insper-riscv/RV32I/src/TIMER/GENERIC_MUX_4X1.vhd

library IEEE;
use IEEE.STD_LOGIC_1164.ALL;

library WORK;

--! Atribui saída conforme entrada selecionada dentre quatro
entity GENERIC_MUX_4X1 is

    generic (
        --! Largura dos vetores de dados
        DATA_WIDTH : natural := 8
    );
        
    port (
        --! Seletor dos vetores de dados
        selector     : in  std_logic_vector(1 downto 0)                := (others => '0');
        --! Vetor de dados 1
        source_1     : in  std_logic_vector((DATA_WIDTH - 1) downto 0) := (others => '0');
        --! Vetor de dados 2
        source_2     : in  std_logic_vector((DATA_WIDTH - 1) downto 0) := (others => '0');
        --! Vetor de dados 3
        source_3     : in  std_logic_vector((DATA_WIDTH - 1) downto 0) := (others => '0');
        --! Vetor de dados 4
        source_4     : in  std_logic_vector((DATA_WIDTH - 1) downto 0) := (others => '0');
        --! Vetor de dados selecionado
        destination  : out std_logic_vector((DATA_WIDTH - 1) downto 0)
    );

end entity;

architecture RTL of GENERIC_MUX_4X1 is

    signal selector_0 : std_logic_vector((DATA_WIDTH - 1) downto 0);
    signal selector_1 : std_logic_vector((DATA_WIDTH - 1) downto 0);

begin

    selector_0 <= (others => selector(0));
    selector_1 <= (others => selector(1));

    destination <=  (
                        (source_1 AND (NOT(selector_0) AND NOT(selector_1))) OR
                        (source_2 AND (selector_0 AND NOT(selector_1)))
                    ) OR (
                        (source_3 AND (NOT(selector_0) AND selector_1)) OR
                        (source_4 AND (selector_0 AND selector_1))
                    );

end architecture;
