insper-riscv/RV32I/L2IP/sw/src/blink.c

#define LED_ADDR ((volatile unsigned int *)0x90000000u)

void delay(int value){
    for (int i = 0; i < value; i++) { __asm__ volatile ("nop"); }
}

int main(void) {
    while (1) {
        *LED_ADDR = 0xFF;
        delay(1000000);
        *LED_ADDR = 0x00;
        delay(1000000);
    }
    return 0;
}
