insper-riscv/RV32I/(commit log)

2025-08-25 Mudanças no top level de acordo com arquitetura RISC-V
2025-08-27 criando exemplo de testes, and gate e mux2x1
2025-08-29 alteração da unidade de controle - adição dos opcodes e tipos de instrução
2025-08-29 unidade de controle com tipos de instrucao
2025-08-29 UC pronta para instrucoes rv32i, sem incluir instrucoes de geracao de excecoes
2025-08-29 instrucoes e adicao da logica de gerador de imediato e extensor de sinal
2025-09-02 testes para os mux
2025-09-02 testes unitarios extensor de sinal
2025-09-02 arrumacoes na unidade de controle e ula e limpeza da estrutura de arquivos e toplevel
2025-09-02 retirada de arquivos inutilizados
2025-09-02 novo banco de registradores (versao do grupo antigo)
2025-09-02 Adicionando banco de registradores e seu teste.
2025-09-03 Implementação funcional banco de registradores
2025-09-03 Refatorando o runner dos testes (agora todos os testes geram waves, sem opcao de escolha)
2025-09-04 Adicionando teste do Banco de Registradores em FPGA
2025-09-07 Documentando implementacao de instrucoes
2025-09-07 Refatoracao readme implementacao de instrucoes
2025-09-08 refatoracoes, traducoes e mudancas de nomes de acordo com a documentacao
2025-09-08 padronizacao de nomes de acordo com documentacao
2025-09-09 ULA pronta, corrigida e otimizada
    [ALU.vhd]
2025-09-09 testes corrigidos para rom e bango de registradores
2025-09-09 adicionadno fluxo de dados etapa 6 implementação
2025-09-09 arrumando nome de sinais de controle de acordo com diagrama da documentacao
2025-09-10 ajustes de implementacao da uc para ficar de acordo com a nova tabela da verdade
2025-09-11 unidade de controle pronta
2025-09-11 decoder e package (+body) prontos para compilacao
2025-09-11 arrumacoes para compilacao
2025-09-11 adicionando dados
    [riscv_opcodes.csv]
2025-09-11 Testes decoder feito
    [riscv_opcodes.csv]
2025-09-17 alteracoes no RAM, Extender RAM. Criacao de StoreManager. Criaca de seus testes.
    [riscv_opcodes.csv]
2025-09-17 reestruturando pastas para teste de entidade e instrucoes
    [riscv_opcodes.csv]
2025-09-17 modificando runner para separar pasta simbuild entre entities e instructions
2025-09-17 Corrigindo diretorio de sim_build para instrucoes
2025-09-18 Teste instrucoes de branch.
    [riscv_opcodes.csv]
2025-09-19 documentacao dos testes de instrucoes
2025-09-21 Correcao tipo de extensao de sinal
    [riscv_opcodes.csv]
2025-10-09 corrigindo funcao jalr
    [riscv_opcodes.csv]
2025-10-15 teste em FPGA do risc com a nova memória ROM de leitura assincrona
    [riscv_opcodes.csv]
2025-10-20 setup hw e lw
    [riscv_opcodes.csv]
2025-10-22 correcao estrtutura de pastas
    [riscv_opcodes.csv]
2025-10-28 boot de programas em C sem constantes e sem variaveis globais
2025-11-06 aletercao na ram simulacao e no seu teste para ter leitura sincrona
2025-11-06 teste instructions one modificado para o cpu 3 stage
2025-11-06 teste instructions two modificado para o cpu 3 stage
2025-11-06 teste instructions three modificado para o cpu 3 stage
2025-11-06 teste instructions four modificado para o cpu 3 stage
2025-11-06 teste instructions five modificado para o cpu 3 stage
2025-11-06 teste instructions six modificado para o cpu 3 stage
2025-11-06 correcao runner para criar em sim build as pastas dos testes das instrucoes com o nome correto
2025-11-07 cpu 3 stage funcionando com codigo C
2025-11-07 L2IP alterado para usar componente do core e memorias
2025-11-07 L2IP alterado para usar componente isolado do core e memorias IP
2025-11-24 GPIO + 2 códigos de teste
2026-03-12 feature/ Stall, core, novos sinais, preparação do decoder para Mult, preparação de todo o Core para receber o módulo de Mult que fizemos (tudo deste commit fiz sozinho)
    [InstructionDecoder.vhd, rv32i3stage_core.vhd]
2026-03-18 fix/ usando o mult correto
    [div.vhd, mult.vhd]
2026-03-23 erro de formatacao
2026-03-23 edge dectector e extensor de sinais no qsf
2026-03-23 voltando o multdiv como tava
2026-03-24 fix: extensao M passa na FPGA - divu, clock 1MHz
    [divu.vhd, multdiv.vhd, pll_0002.v]
2026-04-10 feat: Criação de arquivo com padronização de nomes dos sinais para o pipeline + package para padronização dos tipos
2026-04-11 feat(pipeline): add pc_fetch IF stage module
2026-04-11 feat(pipeline): add control_unit decoder replacement
    [control_unit.vhd]
2026-04-11 chore(pipeline): switch project integration to pipeline core
2026-04-14 feat: scripts de KPI, README e baseline 2025.2 fixo
2026-04-14 feat(kpi): add scripts de medicao de KPIs, README e snapshot do baseline 2025.2
2026-04-14 fix: Adding signals isMulDiv and valid to bubble_mux and isolating it from the other signals. Switching the Pipeline diagram for a better quality one
    [bubble_mux.vhd, hazard_detection_unit.vhd, rv32im_pipeline_core.vhd]
2026-04-16 fix: Arrumando o sinal de exImm
    [bubble_mux.vhd, reg_ID_EX.vhd, rv32im_pipeline_core.vhd]
2026-04-16 fix: correções do uso do funct3 no pipeline core
    [rv32im_pipeline_core.vhd]
2026-04-29 Enviando arquivos de design
2026-09-09 Redesign core memory as BOOT_ROM+FLASH+RAM (Harvard modificado), fix two real-hardware bugs, resize to fit
    Replaces the single ROM/ROM_MEM+RAM Harvard-strict map with 3 logical
    roles: BOOT_ROM (fixed, IF-only, never JTAG-rewritten), FLASH (this
    test's own firmware, IF-only), and RAM (real read/write data, the only
    memory the MEM stage was originally wired to touch). See Tests' own
    docs/MEMORY_ARCHITECTURE.md for the full picture — memory map, LED
    meanings, JTAG instance indices.
    rv32im_pipeline_core.vhd: IF stage now decodes BOOT_ROM vs FLASH by a
    purely combinational address compare (is_boot_rom_if) feeding a single
    shared if_addr/if_rden bus — an earlier, registered version of this
    se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
    [boot_rom1port.vhd, core_fpga_test.vhd, flash1port.vhd, flash_mem1port.vhd, rv32i3stage_core_sim_test.vhd]
2026-09-09 pll_0002: lower clock from 83MHz to 50MHz (both PLL outputs, phases recalculated)
    Restores the config this session's whole real-hardware verification
    (both bug fixes above, the resize, the full 81-test run) actually ran
    against — it was already sitting uncommitted in the working tree from
    before this session, with correctly recalculated phase shifts for the
    new period (6667ps/13333ps = 1/3 and 2/3 of 20ns, vs. 4016ps/8032ps for
    the old 12.05ns period), not a partial edit. Committing as-is since
    it's the tested, working state; the original motivation for the drop
    (likely more timing margin while bringing up the new memory map) isn't
    recorded anywhere I could find — flagging here in case i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
    [pll_0002.v]
